EGR314-2025-F-315/phoenixforce.github.io/final-report/index.html

--- layout: none title: Final Report · Phoenix Force · EGR314 --- {% include nav.html %}

## On this page

Final Deliverable

# Team Final Report

Phoenix Force TerraGuard Rover, EGR 314 (Fall 2025). One page with every artifact: report, code, diagrams, media, and lessons.

Jump

## Key pages

System Verification Block Diagram Component Selection Innovation Poster Resources Reflection

Report

## Team Final Report (PDF)

Download PDF Open in new tab

Full text is embedded below. Everything else on this page mirrors and expands the deliverable for a single-stop view.

Summary

## Project snapshot

Mission

TerraGuard rover and screen host their own Wi‑Fi AP, stream metrics and MJPEG video, and alert through LEDs and speaker when gas readings look risky. Built to work offline and remain glove-friendly.

- Two boards: rover (sensing and compute) and screen (HMI).
- HTTP GET polling to rover-hosted AP at 192.168.4.1.
- LEDs and speaker on both boards for clear alerts.

Highlights

- Stable AP link with continuous metrics and MJPEG stream.
- Gas classifications drive LEDs and audio on both boards.
- Power rails verified; GPS and drive tested on final PCB.
- Poster, UI mockups, and comm sequence captured below.

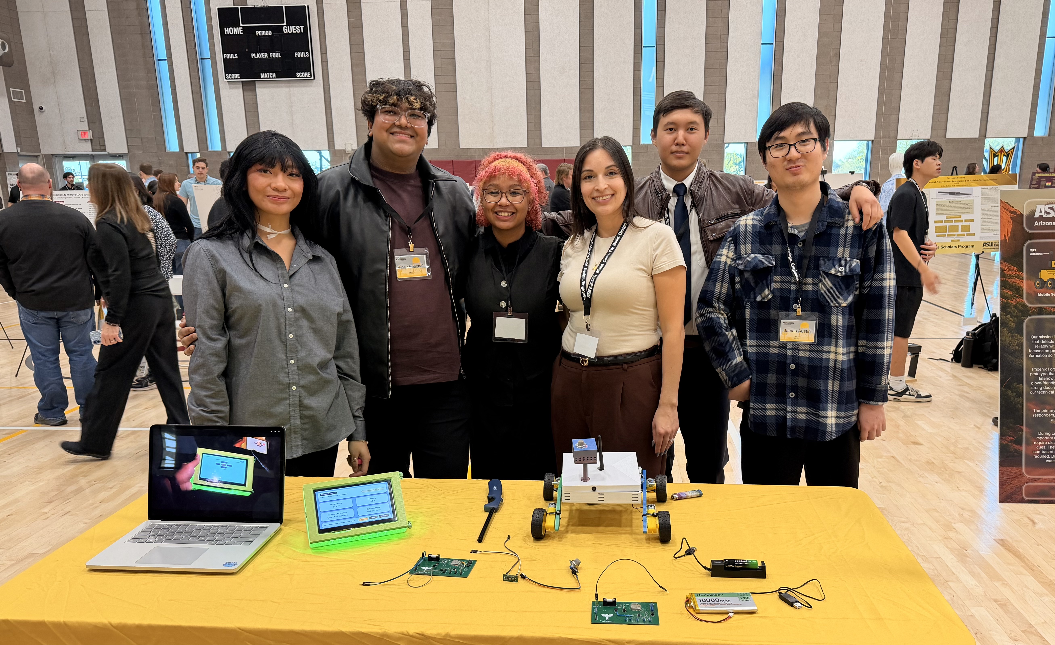
[picture p1: assets/hero_group_image.jpeg]
Final build


System

## Architecture, protocol, and sequence

### Block diagram (final)

Block diagram

HTTP GET to /metrics and /coords; MJPEG stream at /stream; AP hosted by rover.

### Communication sequence

Communication sequence

Screen drives periodic pulls; rover responds with metrics and frames, keeping UI responsive even when frames drop.

UI

## HMI design process

Early LVGL mockups for the screen module informed layout and color cues for gas states.

Main display mockup Drive interface mockup

Hardware

## Schematic and PCB

Schematic PCB editor view PCB front PCB back Assembled PCB photo

Power

## Power budget

Single 7.4 V pack feeds 5 V and 3.3 V rails with at least 25 percent headroom.

Rail | Load | Current (mA) | Regulator | Headroom
5 V | L298N motor driver | 800 | L7805CV (1500 mA) | About 500 mA remaining
3.3 V | ESP32-WROOM, BME688, MQ-2 logic, camera, GPS, programmer | About 567 | LM3940 (1000 mA) | About 433 mA remaining

Battery: 7.4 V 10,000 mAh pack at roughly 454 mA estimated draw gives about 22 hours theoretical before converter losses. Power budget guided trace sizing and kept LEDs on 5 V to isolate the MCU rail.

Notes

## Challenges and what we learned

- Subsystems worked alone, but integration and compile/link issues took the most time; we kept a single code owner to stabilize merges.
- Mixing KiCad and Altium slowed layout; we standardized on one ECAD tool and will keep that discipline going forward.
- PCB feedback: tighten trace routing and keep consistent widths; captured for the next spin.
- Communication kept simple—HTTP GET over rover AP—because it was the most debuggable under deadline.
- Poster was built in Photoshop to match ASU Innovation Showcase specs, with a Sedona-style backdrop and floating glass panes to echo the “panes of information” ask.

BOM

## Final major components

Summary of the key parts on the final build. Passive parts omitted.

Subsystem | Part | Link | Notes
Compute | ESP32-WROOM-32U | Link (https://www.digikey.com/en/products/detail/espressif-systems/ESP32-WROOM-32U/9385967) | Rover MCU and AP host
HMI | ESP32-S3 7" Elecrow Display | Link (https://www.elecrow.com/7-inch-esp32-display-800x480-lvgl.html) | Screen module with speaker and LEDs
Sensing | BME688 | Link (https://www.digikey.com/en/products/detail/bosch-sensortec/BME688/13681261) | Air quality and gas resistance
Sensing | MQ-2 Gas/Smoke Module | Link (https://a.co/d/e4hOBhI) | Fast gas thresholding
Position | u-blox NEO-6M GPS | Link (https://a.co/d/8vv5KV7) | UART GPS for coords
Actuation | L298N Motor Driver | Link (https://a.co/d/f2wVPY0) | Dual H-bridge
Indicators | WS2812B LED Strip | Link (https://a.co/d/1gp2LhV) | Status and air-quality feedback
Power | L7805CV and LM3940 | Link (https://www.digikey.com/en/products/detail/stmicroelectronics/L7805CV/591234) | 5 V and 3.3 V rails from 7.4 V pack
Energy | 7.4 V Li-ion pack | Link (https://a.co/d/2eNwMD9) | Main rover supply

Code

## Firmware and files

ESP32 Code (zip) Final BOM (xlsx) Innovation Poster (PDF)

Code pulled live from the repo so it stays current.

sketch_nov24a.ino — Rover

TerraGuard_HMI.ino — Screen

Showcase

## Innovation Showcase Poster

Built in Photoshop for ASU Innovation Showcase. Sedona-inspired backdrop with rover heading toward a fire; floating glass panes carry each required content block.

Open PDF Download JPG

Innovation poster

Retro

## Lessons and Version 2.0

Top lessons: pick one ECAD tool, budget integration time, document endpoints, and keep LEDs and audio mirrored on both boards. Version 2.0: add command channel, shrink payloads, add RF shielding and test pads, and include current sensing.

See full reflection →

Team

## Team contributions

### Vinny Panchal

Firmware for rover and screen, LVGL UI, MJPEG handling, PCB design, poster layout, site build, and integration support across subsystems.

### Emonie France

Poster content, build support for rover and screen, printing and presentation prep, and debugging help.

### Erjan Baigenzhin

GPS integration and soldering multiple boards; assisted with drive testing.

### Amanda Pizarro

Gas sensing support and reviews on sensor integration.

### James Austin

Power subsystem bring-up and verification of rails.

### Danitza Jimenez

Power budget, block diagram support, CAD models, and 3D printing for needed parts.
