EGR314-2025-F-315/phoenixforce.github.io/innovation-poster/index.html

--- layout: none title: Innovation Showcase Poster · Phoenix Force · EGR314 --- {% include nav.html %}

## On this page

Innovation Showcase

# TerraGuard Poster

Designed in Photoshop to match ASU Innovation Showcase specs—Sedona backdrop with the rover threading toward a fire, information on layered glass panes to mirror the requested panel structure.

Poster

## Innovation Showcase

Open PDF Download JPG

Visual language: rover navigating a Sedona-like terrain toward a detected fire, with floating glass panes holding each content block—literal panels for the required sections.

Innovation Showcase Poster
