EGR314-2025-F-315/phoenixforce.github.io/assets/Block_Diagram.png

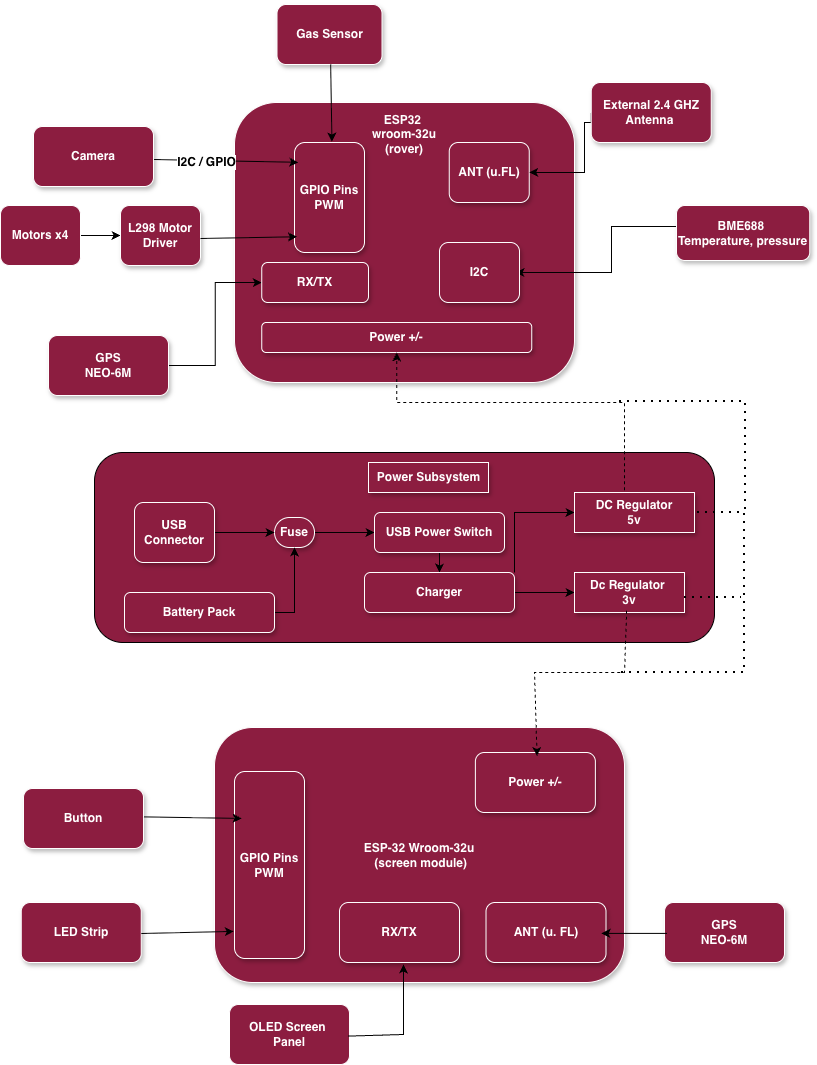
assets/Block_Diagram.png
