EGR314-2025-F-315/phoenixforce.github.io/assets/BME_pcb.png

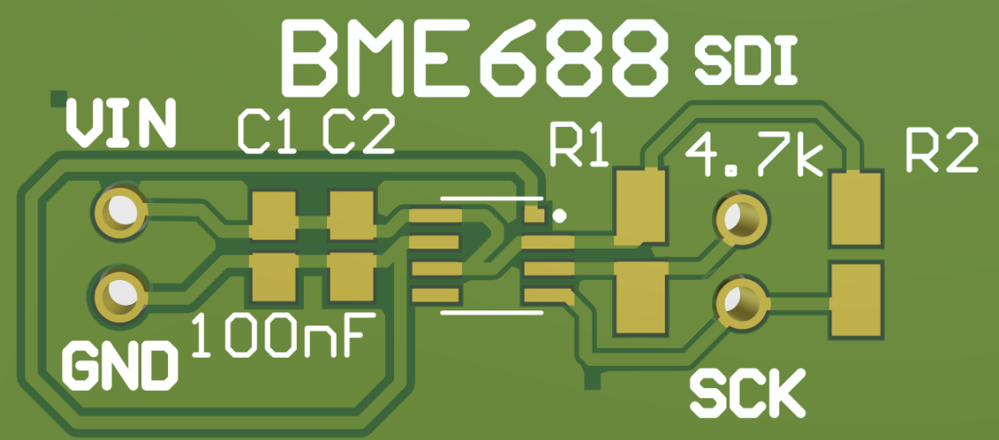
assets/BME_pcb.png
