EGR314-2025-F-315/phoenixforce.github.io/assets/comm_sequence.png

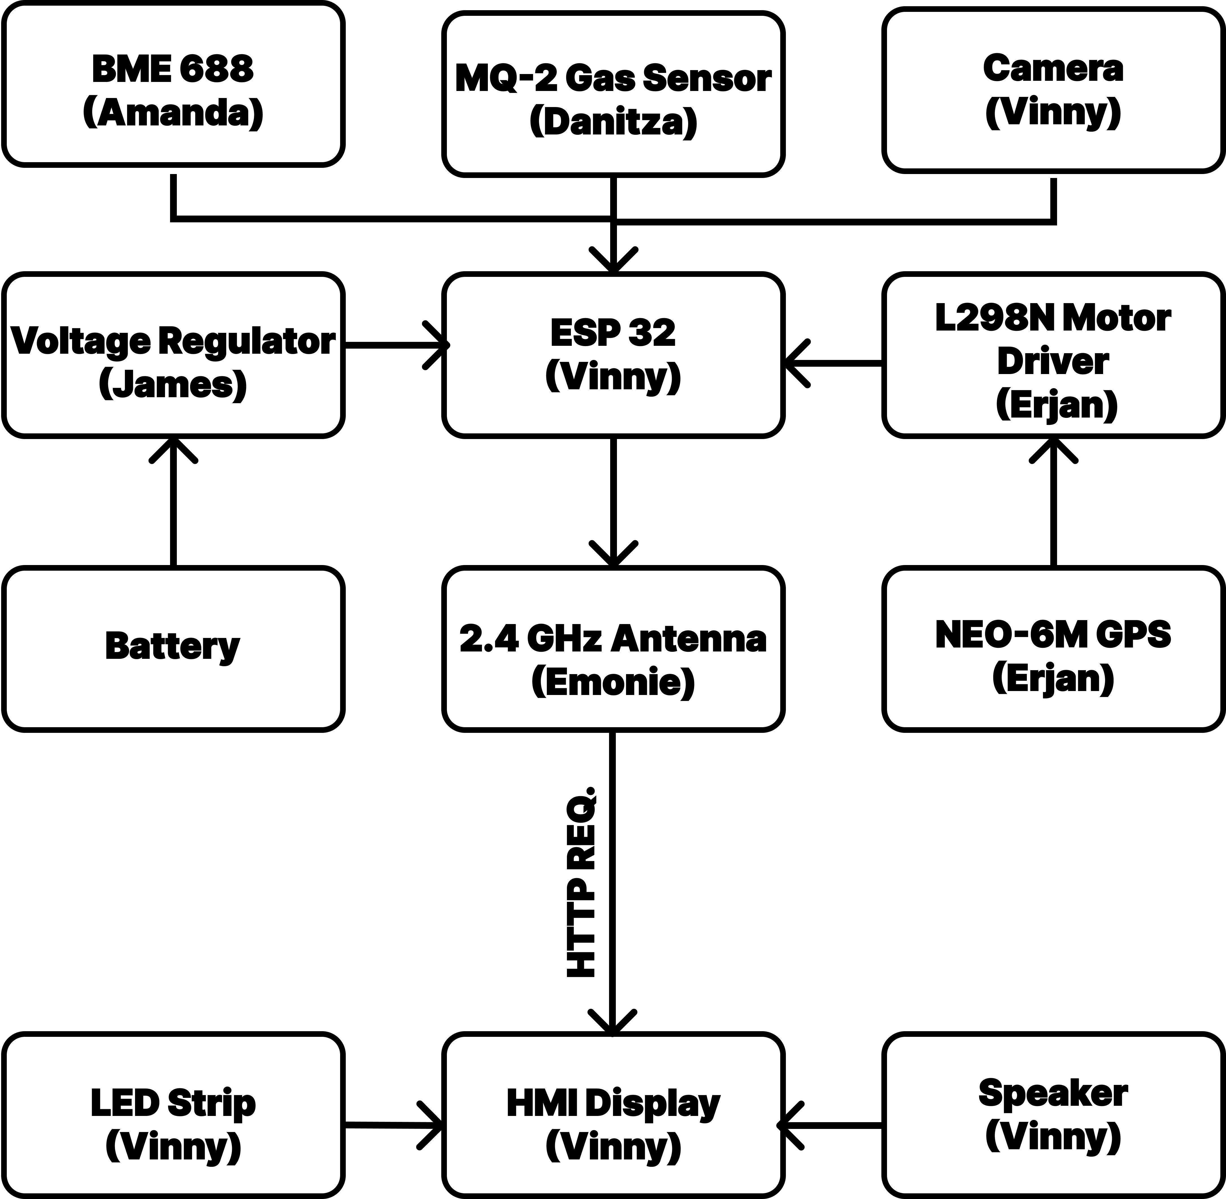
assets/comm_sequence.png
