EGR314-2025-F-315/phoenixforce.github.io/assets/concept-sketch.png

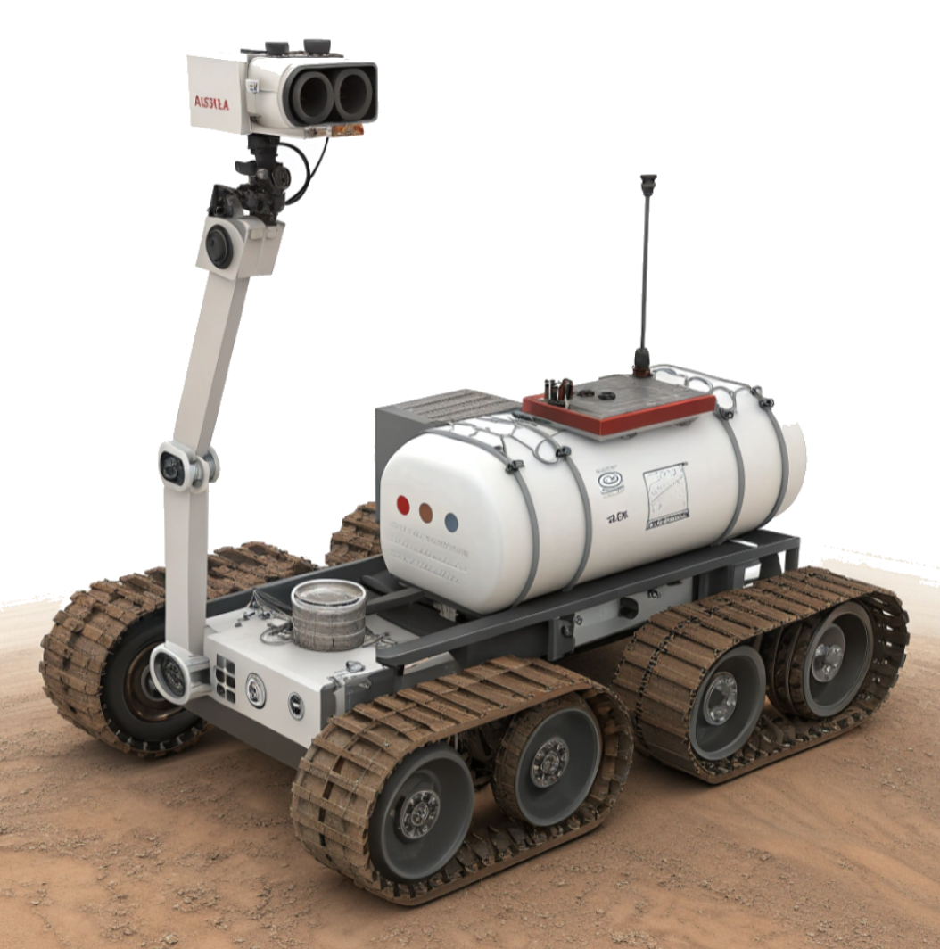
assets/concept-sketch.png
