EGR314-2025-F-315/phoenixforce.github.io/assets/drive_interface_mockup.png

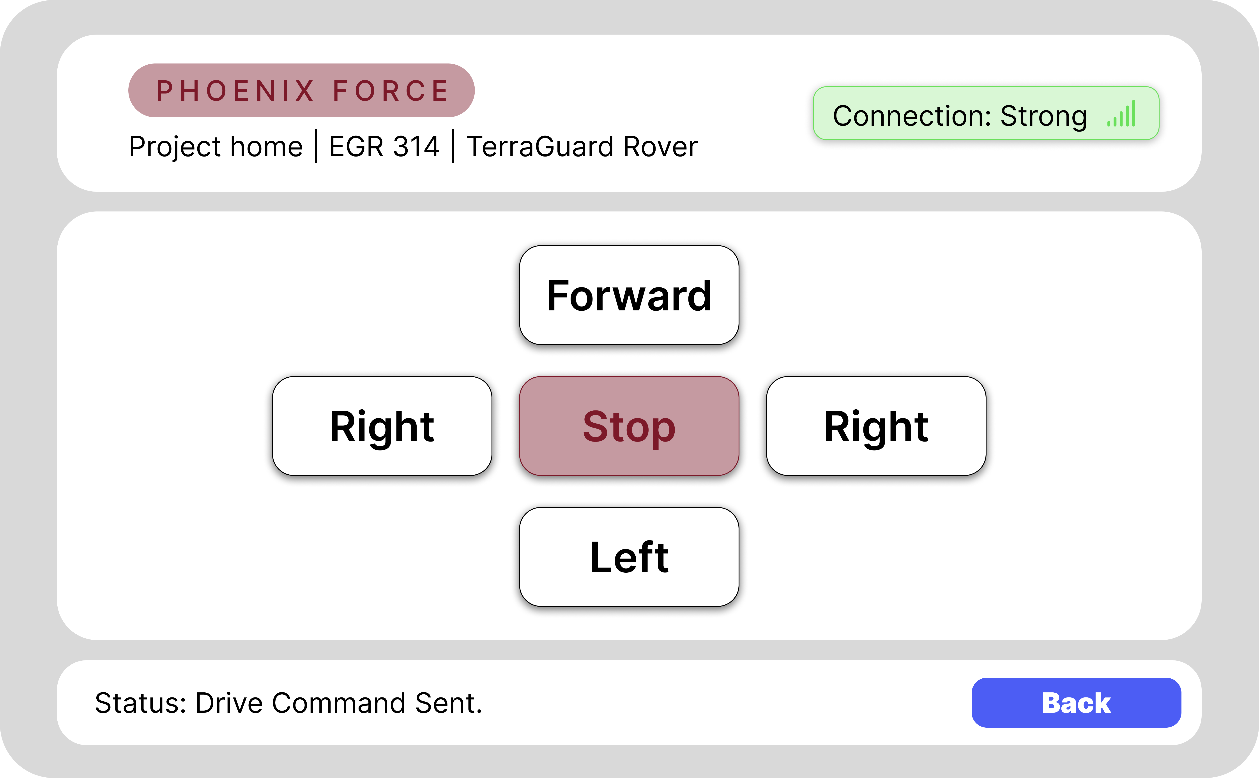
assets/drive_interface_mockup.png
