EGR314-2025-F-315/phoenixforce.github.io/assets/hero.png

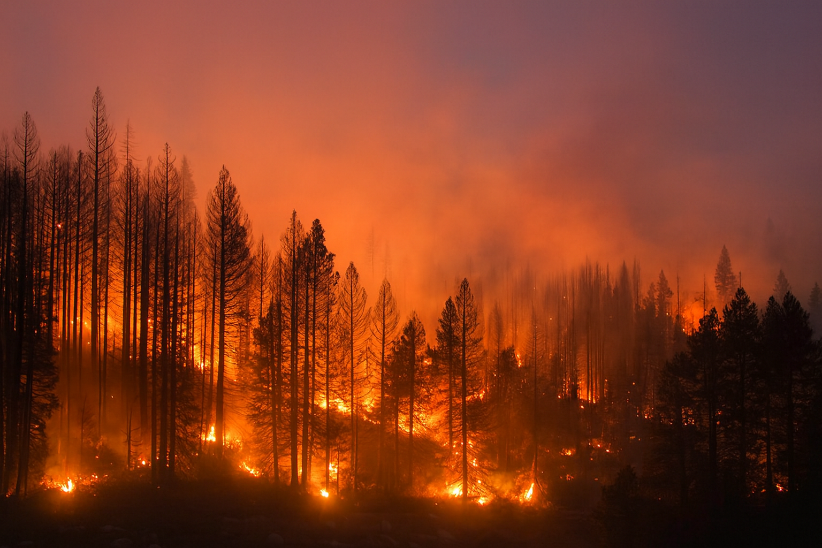
assets/hero.png
