EGR314-2025-F-315/phoenixforce.github.io/assets/innovation-poster.jpg

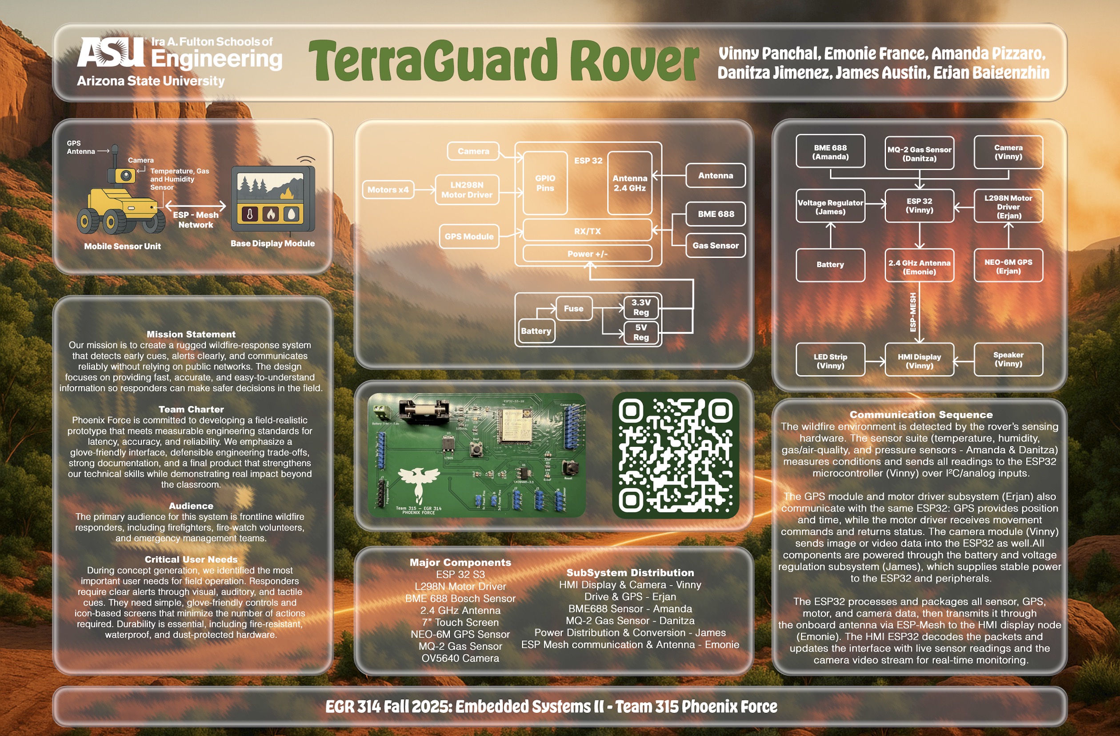
assets/innovation-poster.jpg
