EGR314-2025-F-315/phoenixforce.github.io/assets/main_display_mockup.png

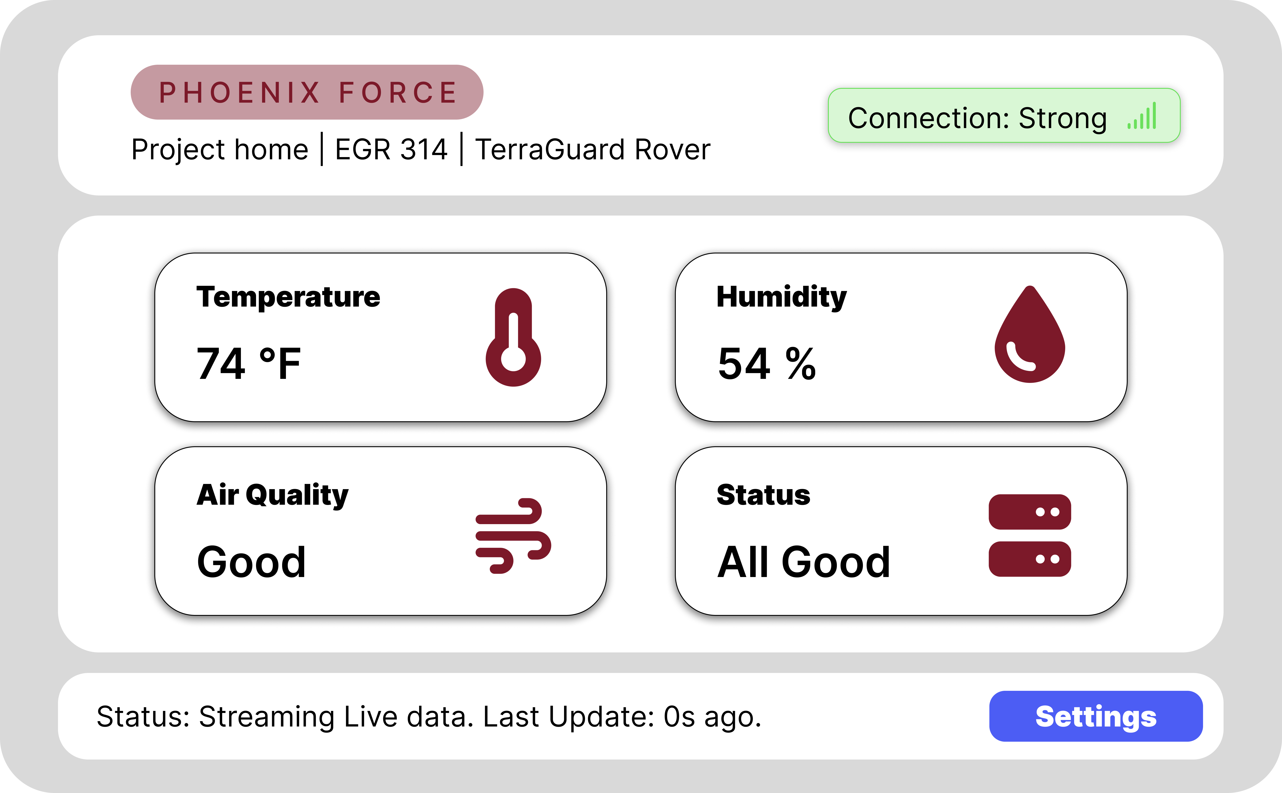
assets/main_display_mockup.png
