EGR314-2025-F-315/phoenixforce.github.io/assets/PCB_BACK.png

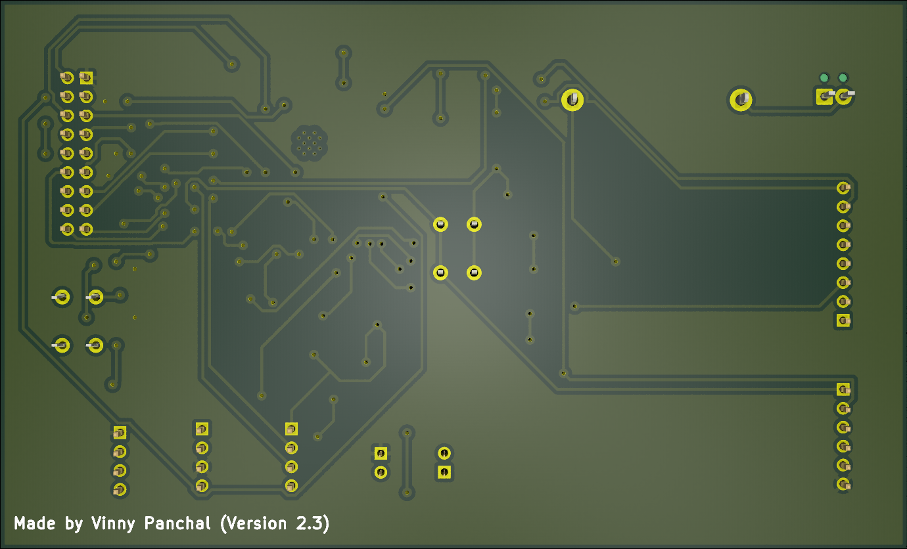
assets/PCB_BACK.png
