EGR314-2025-F-315/phoenixforce.github.io/assets/PCB_FRONT.png

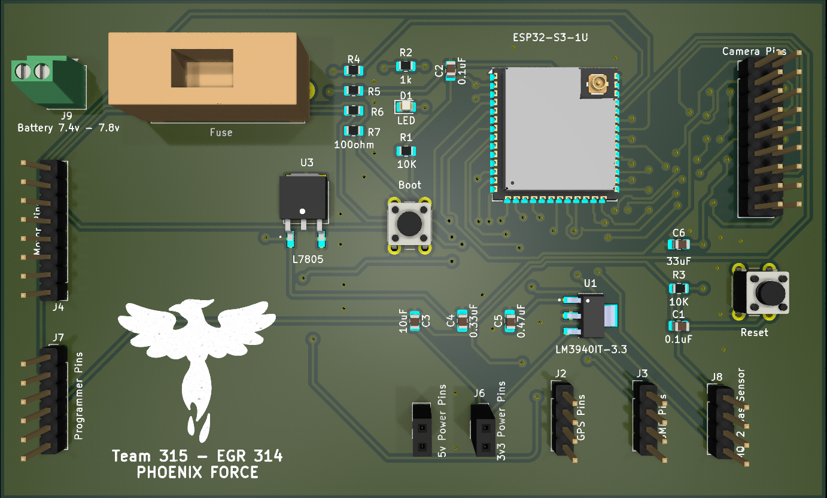
assets/PCB_FRONT.png
