EGR314-2025-F-315/phoenixforce.github.io/assets/pcb_kicad_pcb_editor.png

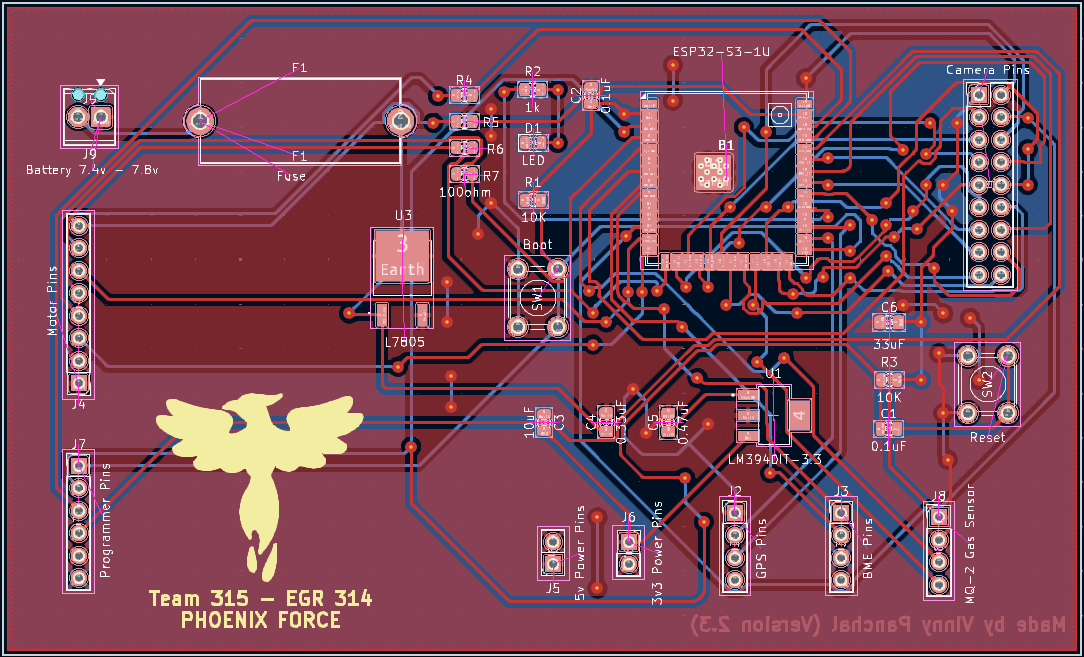
assets/pcb_kicad_pcb_editor.png
