EGR314-2025-F-315/phoenixforce.github.io/assets/ROVER_RENDER_SIDE.png

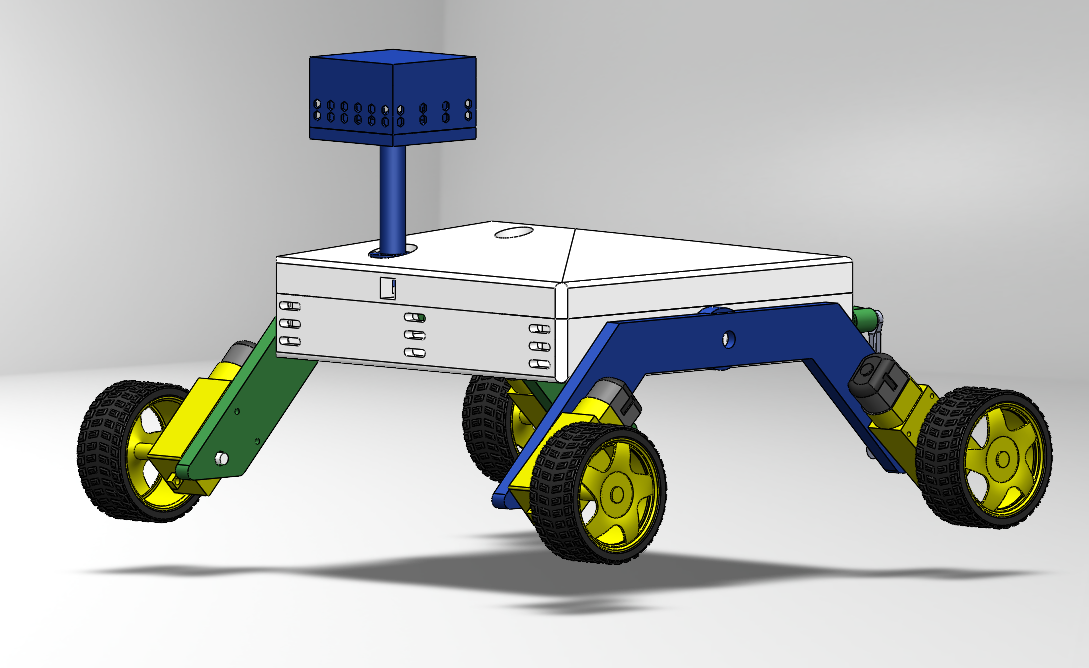
assets/ROVER_RENDER_SIDE.png
