EGR314-2025-F-315/phoenixforce.github.io/assets/schematic.png

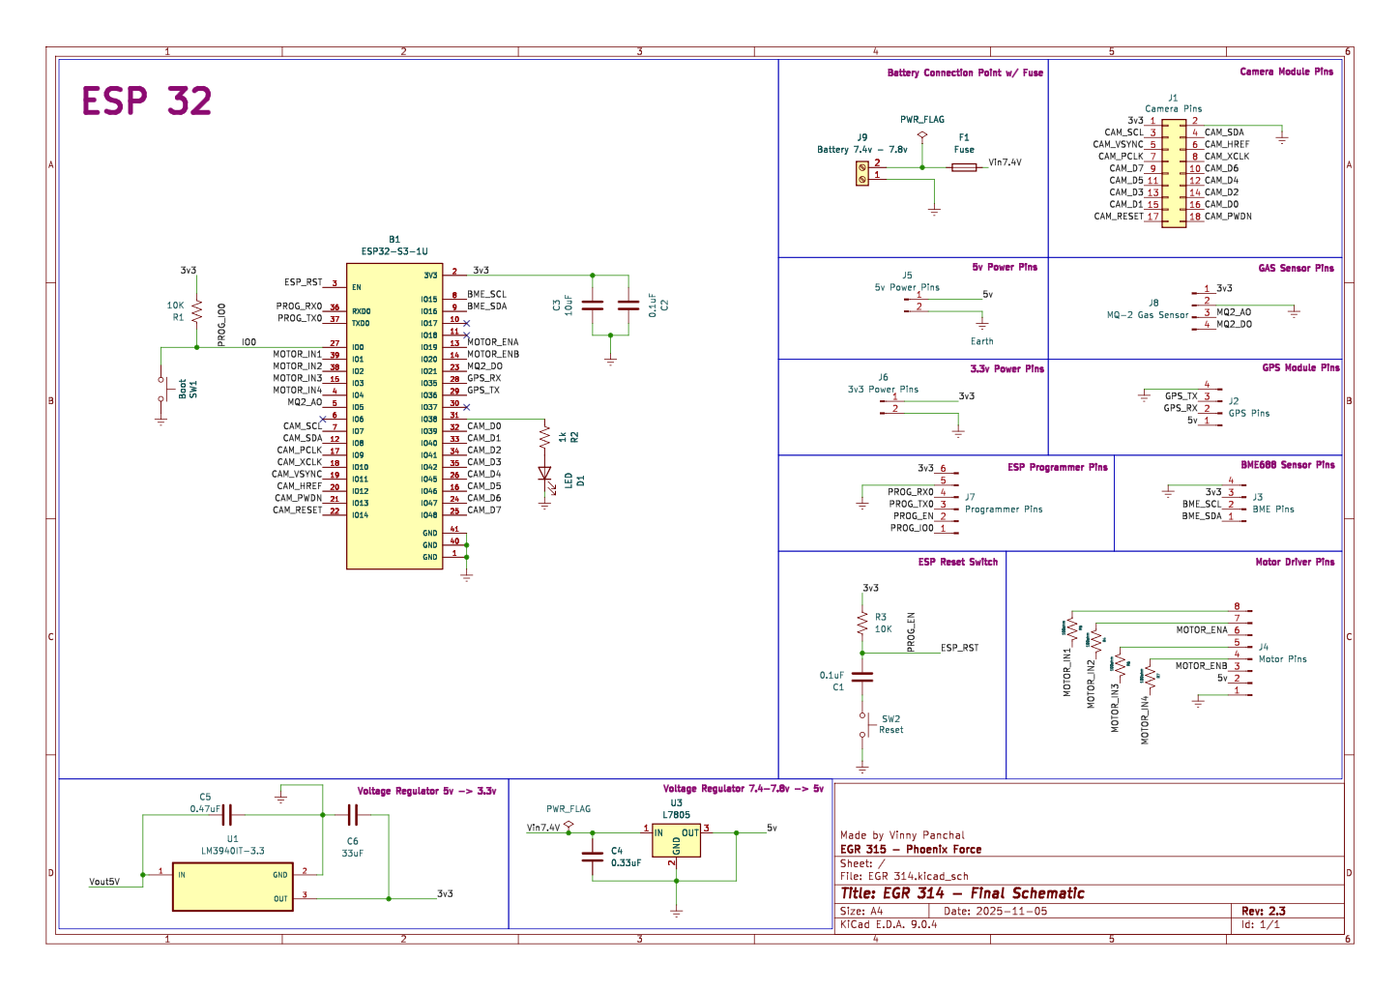
assets/schematic.png
