EGR314-2025-F-315/phoenixforce.github.io/assets/SCREEN_RENDER.png

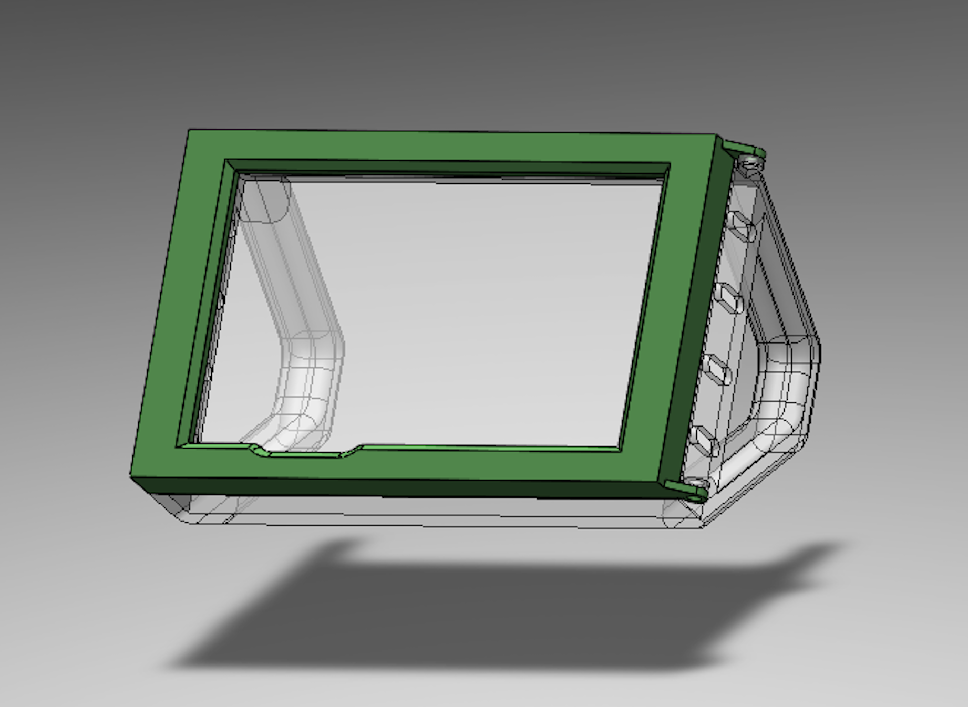
assets/SCREEN_RENDER.png
