EGR314-2025-F-315/phoenixforce.github.io/assets/team-block-diagram.png

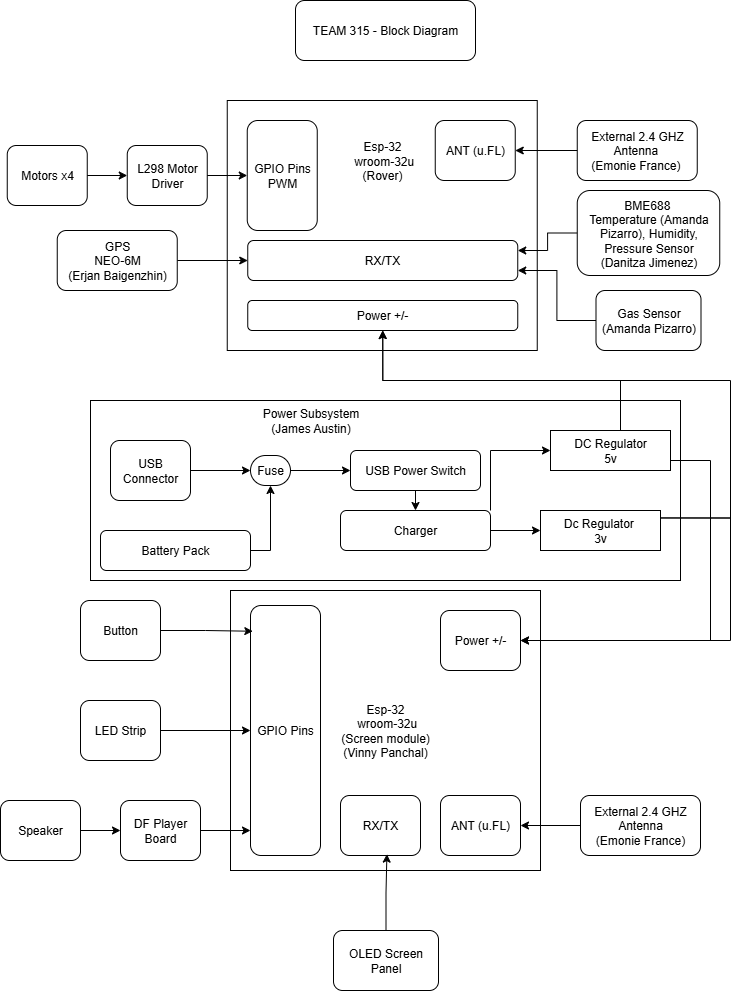
assets/team-block-diagram.png
