EGR314-2025-F-315/phoenixforce.github.io/assets/BOM.xlsx

Number | Item Name | Subsystem | Link | Price | Quantity | Line Total
1 | 7" Touch Display | Screen / HMI | Link (https://a.co/d/hGGLEXS) | $52.99 | 1 | $52.99
 | 3w 8ohm Speaker | Screen / HMI | Link (https://a.co/d/8c46tZd) | $7.99 | 1 | $7.99
3 | LED Strip | Screen / HMI | Link (https://a.co/d/dk5nyY2) | $13.99 | 1 | $13.99
4 | ESP 32 Cam 2.4 ghz | Communication, Screen / HMI, Rover | Link (https://a.co/d/1nRsot3) | $19.99 | 1 | $19.99
5 | 2.4 ghz Antenna | Communication, Rover, Screen / HMI | Link (https://a.co/d/0IPVCh6) | $9.99 | 1 | $9.99
6 | GY-NEO6MV2 NEO-6M GPS | Drive, Rover | Link (https://a.co/d/3P0rsgQ) | $9.99 | 1 | $9.99
6 | MCP9808 TEMP SENSOR | Sensors, Rover | Link (https://www.digikey.com/en/products/detail/microchip-technology/MCP9808-E-MS/2802083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) | $1.40 | 3 | $4.20
7 | BME688 GAS SENSOR | Sensors, Rover | Link (https://www.digikey.com/en/products/detail/bosch-sensortec/BME688/13681261) | $8.65 | 3 | $25.95
8 | 2 L298n and 4 motors kit | Drive, Rover | Link (https://a.co/d/2i9xPt1) | $15.99 | 1 | $15.99
9 | Battery | Power, Screen / HMI | Link (https://a.co/d/6H9fyUC) | $15.99 | 2 | $31.98
10 | Camera | Rover, Sensors | Link (https://a.co/d/4zPtyLe) | $27.99 | 1 | $27.99
11 | Rover Battery | Power, Rover | Link (https://a.co/d/dW6Hceo) | $37.99 | 1 | $37.99
12 | 18650 Holder | Power, Rover | Link (https://a.co/d/5Dklx5h) | $9.99 | 1 | $9.99
14 | Backup MQ2 Gas Sensor | Sensors, Rover | Link (https://a.co/d/1wPottj) | $11.99 | 1 | $11.99
15 | Buck Convertor | Rover, Power | Link (https://a.co/d/hFy6E5g) | $7.39 | 1 | $7.39
16 | SHT40-CD1B-R3 | Sensors, Rover | Link (https://www.digikey.com/ordering/shoppingcart) | $1.80 | 3 | $5.40
Total |  |  |  |  |  | $293.81
