EGR314-2025-F-315/phoenixforce.github.io/(commit log)

2025-10-01 updated bom
2025-10-08 changes to component selection
    [BOM.xlsx]
2025-12-09 cad files
